marangisto/Beats/Board-render-back.png

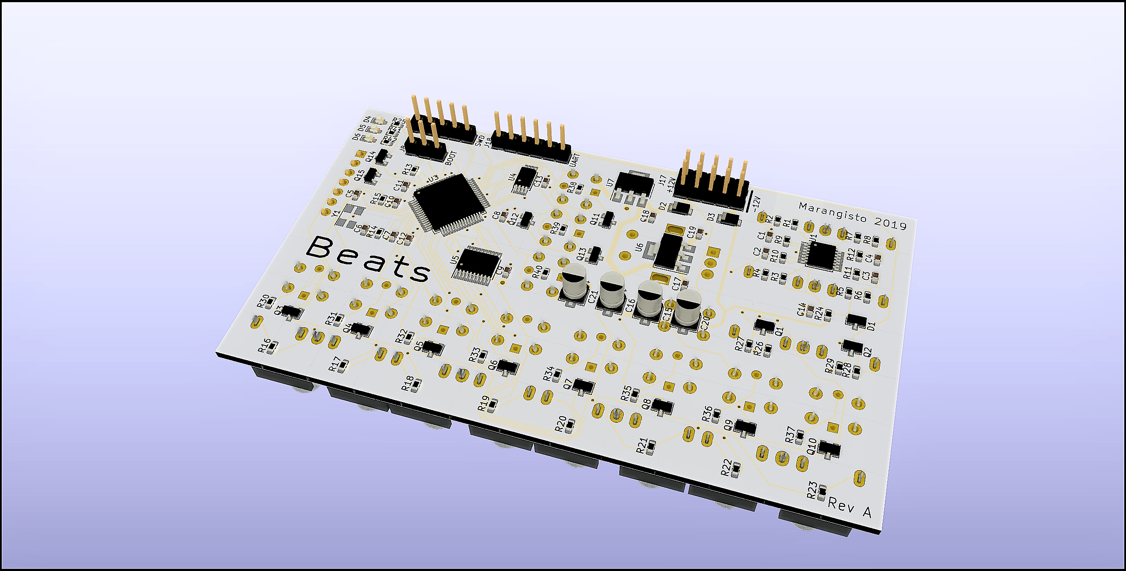
Board-render-back.png
