marangisto/Beats/Beats-2019-May-18.jpg

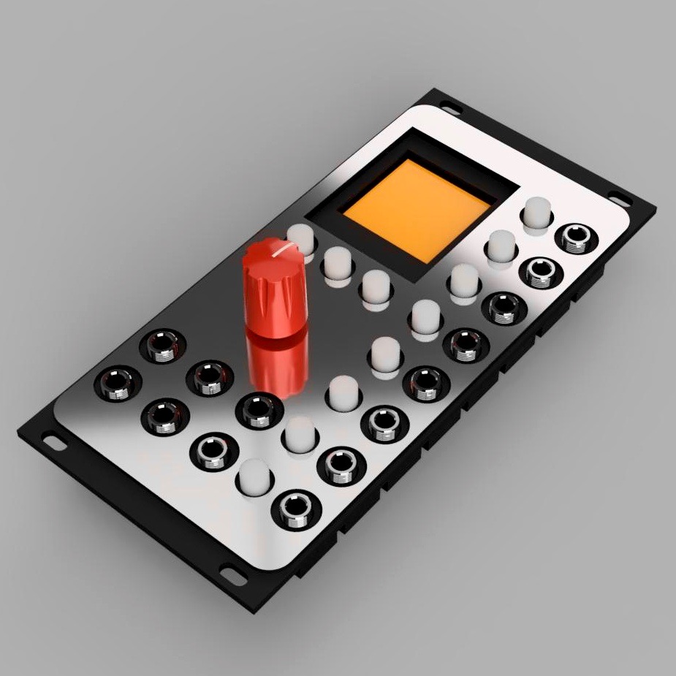
Beats-2019-May-18.jpg
