marangisto/Beats/Board-render-front.png

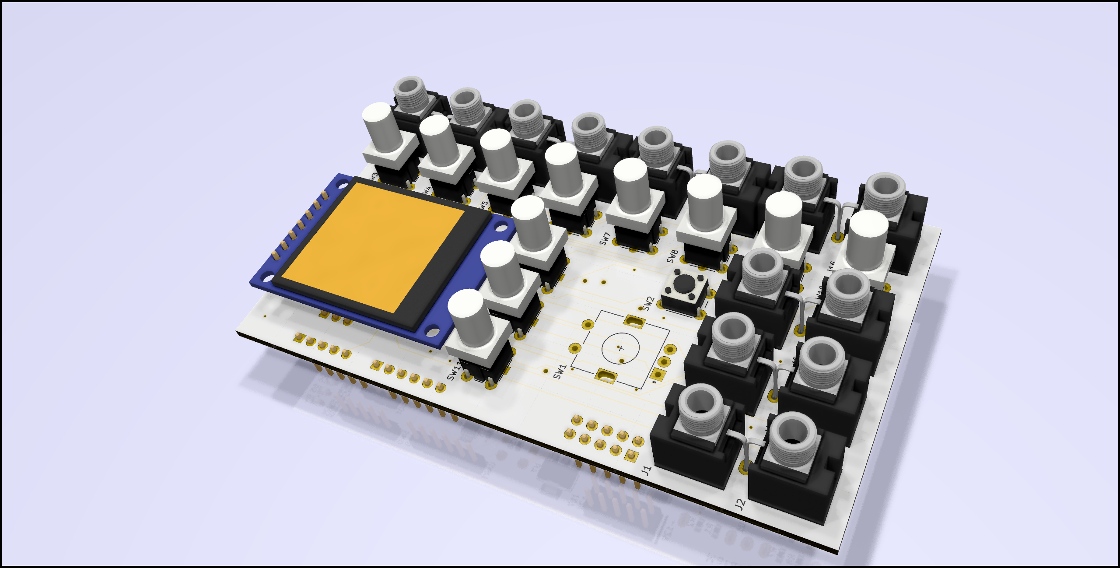
Board-render-front.png
