marangisto/Beats/Board-trace.png

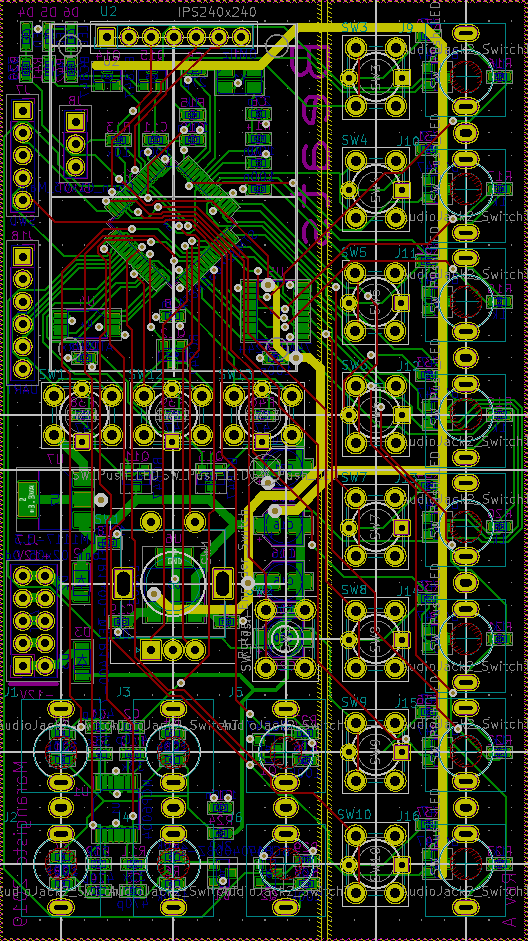
Board-trace.png
