marangisto/Beats/drawing.dxf

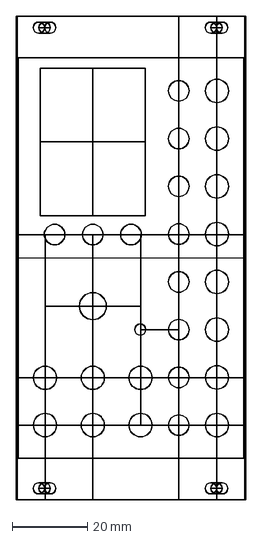
[picture p5: CAD file, 2019-05-26]
drawing.dxf
61.0 x 128.5 mm
