marangisto/Beats/edgecuts.dxf

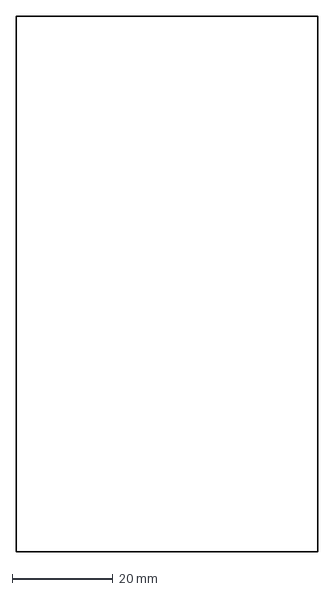
[picture p6: CAD file, 2019-05-25]
edgecuts.dxf
60.0 x 106.5 mm
