marangisto/Beats/Beats.kicad_pcb

## KiCad design Beats.kicad_pcb (2019-05-27)

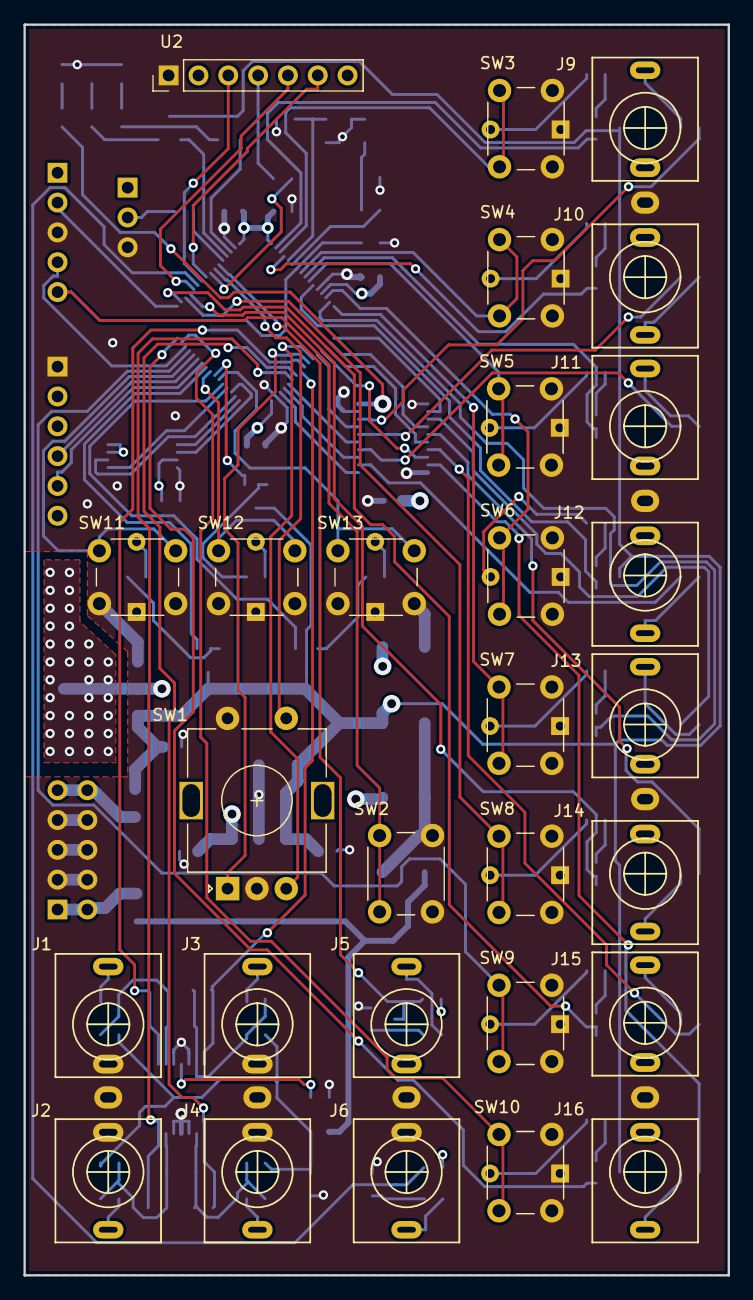
[picture p7: board Beats.kicad_pcb from above]

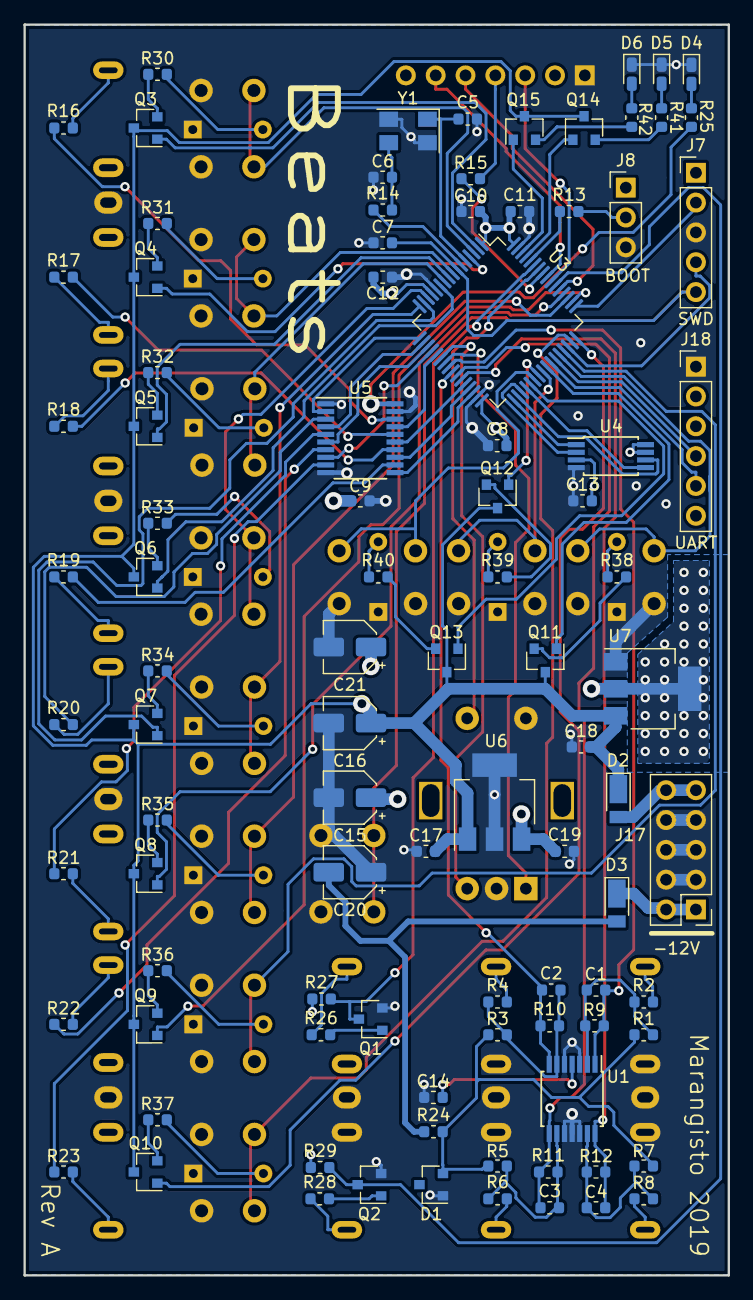
[picture p8: board Beats.kicad_pcb from below]

Board: 4 copper layers, 60.0 x 106.5 mm, 123 parts (95 on the bottom side), 123 nets.

Parts:
C1, C2, C3, C4: 470p; C_0603_1608Metric
C5, C6: 27p; C_0603_1608Metric
C7, C9, C10, C11, C12, C13, C14, C17, C18, C19: 100n; C_0603_1608Metric
C8: 10n; C_0603_1608Metric
C15, C16, C20, C21: 10u; CP_Elec_4x5.8
D1: LM4040DBZ-10; SOT-23
D2, D3: DFLR1400-7; D_PowerDI-123
D4, D5, D6: LED; LED_0603_1608Metric_Castellated
J1, J2, J3, J4, J5, J6, J9, J10, J11, J12, J13, J14, J15, J16: AudioJack2_SwitchT; PJ398SM
J7: SWD; PinHeader_1x05_P2.54mm_Vertical
J8: Conn_01x03_Male; PinHeader_1x03_P2.54mm_Vertical
J17: Conn_02x05_Odd_Even; PinHeader_2x05_P2.54mm_Vertical
J18: UART; PinHeader_1x06_P2.54mm_Vertical
Q1, Q2, Q3, Q4, Q5, Q6, Q7, Q8, Q9, Q10, Q11, Q12, Q13, Q14, Q15: BC847; SOT-23
R1, R3, R5, R7: 200k; R_0603_1608Metric
R2, R4, R6, R8, R26, R28: 100k; R_0603_1608Metric
R9, R10, R11, R12: 33k; R_0603_1608Metric
R13, R27, R29: 10k; R_0603_1608Metric
R14: 470; R_0603_1608Metric
R15, R16, R17, R18, R19, R20, R21, R22, R23: 1k; R_0603_1608Metric
R24: 2k2; R_0603_1608Metric
R25: 330; R_0603_1608Metric
R30, R31, R32, R33, R34, R35, R36, R37, R38, R39, R40, R41, R42: 47; R_0603_1608Metric
SW1: Rotary_Encoder_Switch; RotaryEncoder_Alps_EC11E-Switch_Vertical_H20mm
SW2: SW_Push; SW_PUSH_6mm
SW3, SW4, SW5, SW6, SW7, SW8, SW9, SW10, SW11, SW12, SW13: SW_Push_LED; SW_PUSH_LED_6mm
U1: MCP6004; TSSOP-14_4.4x5mm_P0.65mm
U2: IPS240x240
U3: STM32F051R8Tx; LQFP-64_10x10mm_P0.5mm
U4: AT25xxx; TSSOP-8_4.4x3mm_P0.65mm
U5: 74AHCT244; TSSOP-20_4.4x6.5mm_P0.65mm
U6: L7805; SOT-223-3_TabPin2
U7: LM1117-3.3; SOT-223-3_TabPin2
Y1: 8MHz; Crystal_SMD_5032-4Pin_5.0x3.2mm

Connections:
+3.3VA: C8.1, C10.1, C11.1, C12.1, C13.1, C14.1, C21.1, J5.TN, J7.1, J8.1, R27.1, R29.1, U1.4, U2.2, U2.7, U3.1, U3.13, U3.32, U3.64, U4.3, U4.7, U4.8, U7.2
+5V: C9.1, C15.1, C19.1, R25.1, U5.20, U6.3
+12V: C16.1, C17.1, C18.1, D2.1, Q3.3, Q4.3, Q5.3, Q6.3, Q7.3, Q8.3, Q9.3, Q10.3, Q11.3, Q12.3, Q13.3, Q14.3, Q15.3, U6.1, U7.3
-12V: C20.2, D3.2, R24.1
/DigitalIn/In: J5.T, R26.1
/sheet5D7C6377/In: J6.T, R28.1
GND: C5.2, C6.2, C7.2, C8.2, C9.2, C10.2, C11.2, C12.2, C13.2, C14.2, C15.2, C16.2, C17.2, C18.2, C19.2, C20.1, C21.2, D1.1, D4.1, D5.1, D6.1, J1.TN, J2.S, J2.TN, J3.TN, J4.S, J4.TN, J6.S, J6.TN, J7.3, J8.3, J10.S, J12.S, J14.S, J16.S, J17.3, J17.4, J17.5, J17.6, J17.7, J17.8, J18.1, Q1.2, Q2.2, SW1.C, SW1.S2, SW2.1, SW3.2, SW3.4, SW4.2, SW4.4, SW5.2, SW5.4, SW6.2, SW6.4, SW7.2, SW7.4, SW8.2, SW8.4, SW9.2, SW9.4, SW10.2, SW10.4, SW11.2, SW11.4, SW12.2, SW12.4, SW13.2, SW13.4, U1.3, U1.5, U1.10, U1.11, U1.12, U2.1, U3.12, U3.31, U3.63, U4.4, U5.1, U5.10, U5.19, U6.2, U7.1, Y1.2, Y1.4
unnamed: C1.2, R1.1, R2.1, R9.2, U1.2
unnamed: C2.2, R3.1, R4.1, R10.2, U1.6
unnamed: C3.2, R5.1, R6.1, R11.2, U1.9
unnamed: C4.2, R7.1, R8.1, R12.2, U1.13
unnamed: C5.1, U3.5, Y1.1
unnamed: C6.1, R14.2, Y1.3
unnamed: D2.2, J17.9, J17.10
unnamed: D3.1, J17.1, J17.2
unnamed: D4.2, R25.2
unnamed: D5.2, R41.1
unnamed: D6.2, R42.1
unnamed: J1.T, R2.2
unnamed: J2.T, R8.2
unnamed: J3.T, R4.2
unnamed: J4.T, R6.2
unnamed: J8.2, R13.2
unnamed: J9.T, R16.1
unnamed: J10.T, R17.1
unnamed: J11.T, R18.1
unnamed: J12.T, R19.1
unnamed: J13.T, R20.1
unnamed: J14.T, R21.1
unnamed: J15.T, R22.1
unnamed: J16.T, R23.1
unnamed: Q1.1, R26.2
unnamed: Q2.1, R28.2
unnamed: Q3.2, R30.2
unnamed: Q4.2, R31.2
unnamed: Q5.2, R32.2
unnamed: Q6.2, R33.2
unnamed: Q7.2, R34.2
unnamed: Q8.2, R35.2
unnamed: Q9.2, R36.2
unnamed: Q10.2, R37.2
unnamed: Q11.2, R38.2
unnamed: Q12.2, R39.2
unnamed: Q13.2, R40.2
unnamed: Q14.2, R41.2
unnamed: Q15.2, R42.2
unnamed: R13.1, U3.60
unnamed: R14.1, U3.6
unnamed: R15.1, U2.4
unnamed: R16.2, U5.18
unnamed: R17.2, U5.16
unnamed: R18.2, U5.14
unnamed: R19.2, U5.12
unnamed: R20.2, U5.3
unnamed: R21.2, U5.5
unnamed: R22.2, U5.7
unnamed: R23.2, U5.9
unnamed: R30.1, SW3.3
unnamed: R31.1, SW4.3
unnamed: R32.1, SW5.3
unnamed: R33.1, SW6.3
unnamed: R34.1, SW7.3
unnamed: R35.1, SW8.3
unnamed: R36.1, SW9.3
unnamed: R37.1, SW10.3
unnamed: R38.1, SW11.3
unnamed: R39.1, SW12.3
unnamed: R40.1, SW13.3
PA0: SW6.1, U3.14
PA1: Q7.1, U3.15
PA2: SW7.1, U3.16
PA3: U3.17, U5.2
PA4: U3.20, U5.8
PA5: U3.21, U5.17
PA6: SW1.B, U3.22
PA7: SW1.A, U3.23
PA8: Q11.1, U3.41
PA9: J18.5, U3.42
PA10: J18.4, U3.43
PA11: SW11.1, U3.44
PA12: SW9.1, U3.45
PA15: Q9.1, U3.50
PB0: C3.1, R11.1, U1.8, U3.26
PB1: C4.1, R12.1, U1.14, U3.27
PB2: U3.28, U5.15
PB3: U2.3, U3.55
PB4: U2.6, U3.56
PB5: R15.2, U3.57
PB6: SW1.S1, U3.58
PB7: Q1.3, R27.2, U3.59
PB8: Q14.1, U3.61
PB9: Q15.1, U3.62
PB10: U3.29, U5.13
PB11: U3.30, U5.11
PB12: U3.33, U4.1
PB13: U3.34, U4.6
PB14: U3.35, U4.2
PB15: U3.36, U4.5
PC0: SW4.1, U3.8
PC1: Q5.1, U3.9
PC2: SW5.1, U3.10
PC3: Q6.1, U3.11
PC4: C1.1, R9.1, U1.1, U3.24
PC5: C2.1, R10.1, U1.7, U3.25
PC6: Q13.1, U3.37
PC7: SW13.1, U3.38
PC8: Q12.1, U3.39
PC9: SW12.1, U3.40
PC10: SW8.1, U3.51
PC11: Q8.1, U3.52
PC12: U2.5, U3.53
PC13: Q3.1, U3.2
PC14: SW3.1, U3.3
PC15: Q4.1, U3.4
PD2: Q2.3, R29.2, U3.54
PF4: U3.18, U5.4
PF5: U3.19, U5.6
PF6: SW10.1, U3.47
PF7: Q10.1, U3.48
RESET: C7.1, J7.5, SW2.2, U3.7
SWCLK: J7.2, U3.49
SWDIO: J7.4, U3.46
VRef-10: D1.2, R1.2, R3.2, R5.2, R7.2, R24.2
