marangisto/Beats/(commit log)

2019-05-15 Added footprint and model for display.
    [Beats.kicad_pcb, Beats.sch]
2019-05-18 Added footprint and 3d model for led push button.
2019-05-20 First schematic (missing TFT & led-buttons).
    [Beats.sch, DigitalIn.sch, POW5_3V3.sch, VRef-10.sch]
2019-05-21 Use 74AHCT244.
    [Beats.sch, DigitalIn.sch, POW5_3V3.sch, VRef-10.sch]
2019-05-21 Added symbols and adjusted footprints.
    [Beats.sch, DigitalIn.sch, POW5_3V3.sch, VRef-10.sch]
2019-05-22 Added eeprom.
    [Beats.sch, DigitalIn.sch, POW5_3V3.sch, VRef-10.sch]
2019-05-22 Footprint for eeprom.
    [Beats.sch]
2019-05-23 Allocated analog inputs.
    [Beats.sch]
2019-05-25 Some encoder wiring.
    [Beats.sch]
2019-05-25 Added footprint for jacks.
    [Beats.sch]
2019-05-25 Edgecuts and user drawing.
    [Beats.kicad_pcb, drawing.dxf, edgecuts.dxf]
2019-05-25 Initial pin assignments and placement.
    [Beats.kicad_pcb, Beats.sch, PinAssignment.xls]
2019-05-26 Spiced the led driver to size resistor for approx 10mA.
2019-05-26 Added UART and corresponding pin assignments.
    [Beats.kicad_pcb, Beats.sch, DigitalIn.sch, POW5_3V3.sch, PinAssignment.xls, VRef-10.sch]
2019-05-26 Assigned trigger output pins.
    [Beats.kicad_pcb, Beats.sch, DigitalIn.sch, PinAssignment.xls, PushLED.sch]
2019-05-26 Corrected port collisions.
    [Beats.kicad_pcb, Beats.sch, PinAssignment.xls]
2019-05-26 Correct placement of reset switch.
    [Beats.kicad_pcb, drawing.dxf]
2019-05-26 Assigned led and switch pins.
    [Beats.kicad_pcb, Beats.sch, PushLED.sch]
2019-05-26 Update pin-assignment sheet.
    [PinAssignment.xls]
2019-05-26 Added board dimensions.
    [Beats.kicad_pcb]
2019-05-26 All pins assigned and connected.
    [Beats.kicad_pcb, Beats.sch, DigitalIn.sch, POW5_3V3.sch, PinAssignment.xls, PushLED.sch]
2019-05-26 Shared pads adjusment, four-layers and ground-plane fill.
    [Beats.kicad_pcb]
2019-05-26 Improved component placement.
    [Beats.kicad_pcb]
2019-05-26 Fixed wrong voltage on clock / reset inputs and better wiring.
    [Beats.kicad_pcb, Beats.sch, DigitalIn.sch]
2019-05-26 Power and ground planes routed and poured.
    [Beats.kicad_pcb, Beats.sch, DigitalIn.sch, POW5_3V3.sch]
2019-05-26 Keep-outs for jacks.
    [Beats.kicad_pcb]
2019-05-26 Front silk-screen.
    [Beats.kicad_pcb]
2019-05-26 Back silk-screen.
    [Beats.kicad_pcb]
2019-05-26 Branding and legends.
    [Beats.kicad_pcb]
2019-05-26 Pin assingment for input clock and reset signals.
    [Beats.kicad_pcb, Beats.sch, PinAssignment.xls]
2019-05-26 Free-routed signals.
    [Beats.kicad_pcb]
2019-05-27 Added board trace image.
2019-05-27 Added board renderings.
2019-05-27 Added BOM.
    [Beats.csv]
2019-05-27 Stitching of head-sinks for 3.3V.
    [Beats.kicad_pcb]
2019-05-27 Revised chip power connections.
    [Beats.kicad_pcb]
2019-05-27 Pours on top and bottom layers.
    [Beats.kicad_pcb]
2019-05-27 Generated Gerbers.
    [Beats-B_Cu.gbr, Beats-B_Mask.gbr, Beats-B_Paste.gbr, Beats-B_SilkS.gbr, Beats-Edge_Cuts.gbr, Beats-F_Cu.gbr, Beats-F_Mask.gbr, Beats-F_SilkS.gbr]
2019-06-06 Updated C++ Euclidean based on Haskell prototype.
2019-06-08 Added separate firmware for inital bring-up of board.
2019-06-08 All buttons and leds tested.
2019-06-19 Added encoder hardware mappings and show output.
2019-06-24 Corrections for standard RGB color scheme.
    [Main.cpp]
2020-02-22 Use EXTI interrupts for clock and reset inputs.
    [board.h, main.cpp]
2020-02-22 Corrected aux-timer to 1kHz.
    [board.h]
2020-02-22 Added time-to-clear method to leds.
2020-02-23 Initial ADC test skeleton.
2020-02-23 Initial ADC setup.
2020-02-23 Working ADC DMA.
2020-02-23 Moved ADC handling to board header.
2020-02-23 Added automatic switching between external and internal clocks.
2020-02-24 Added EXTI example to debug interrupt handler.
2020-02-24 Realized reset trigger is on a separate interrupt.
    [Main.cpp]
2020-02-24 Fixed reset interrupt problem.
    [board.h, clock.h]
2020-02-24 Measure external bpm and handle switching from internal to external.
2020-02-24 Use separate timer interrupt to monitor external clock.
2020-02-24 Removed probe in UI input polling interrupt.
2020-03-14 Upgraded ADC test for new widget.
2020-03-19 Broke graphics into separate header.
    [main.cpp]
2020-03-19 Wired clock ticks through message queue.
2020-03-21 Embedded graphic in panel with spacer and later tool-bar.
2020-08-16 Added test for encoder.
